TRL-RMF/Caato-Documentation/README.md

# Caato-Documentation

find website at https://trl-rmf.github.io/Caato-Documentation/
