TRL-RMF/Caato-Documentation/src/Chassis.md

# Chassis Assembly

Chassis Assembly of Caato

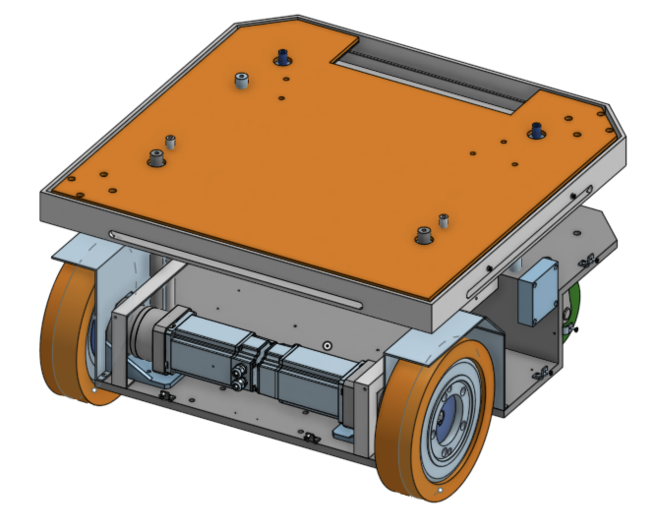
[picture p1: src/img/chassis.png]
Chassis Assembly
