TRL-RMF/Caato-Documentation/src/Drive.md

# Drivetrain Assembly

Drivetrain Assembly of Caato

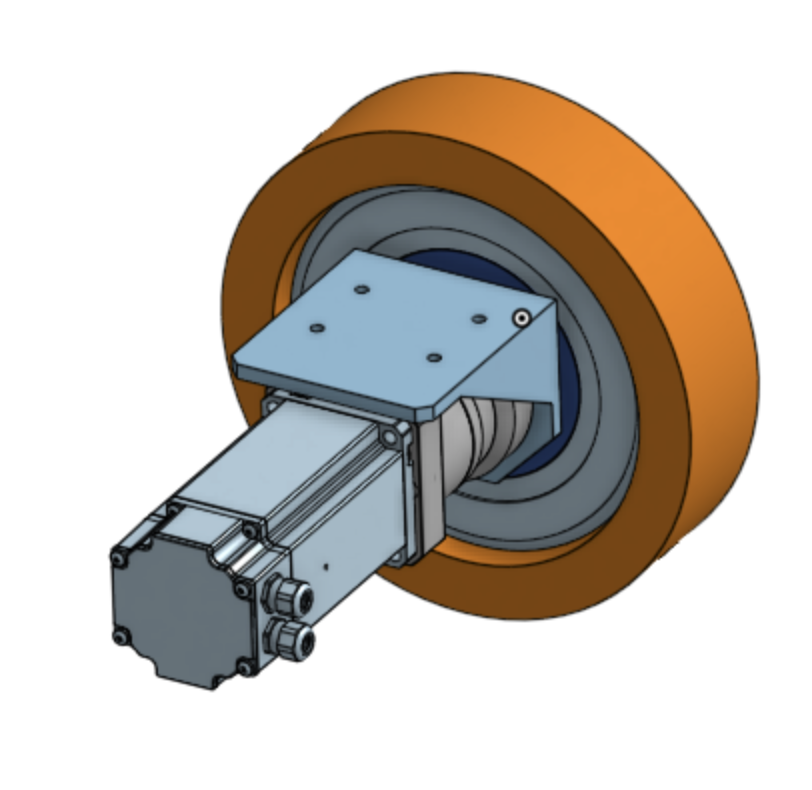
[picture p2: src/img/drive.png]
Drivetrain Assembly
