TRL-RMF/Caato-Documentation/src/Full.md

# Full Assembly

Full assembly of Caato

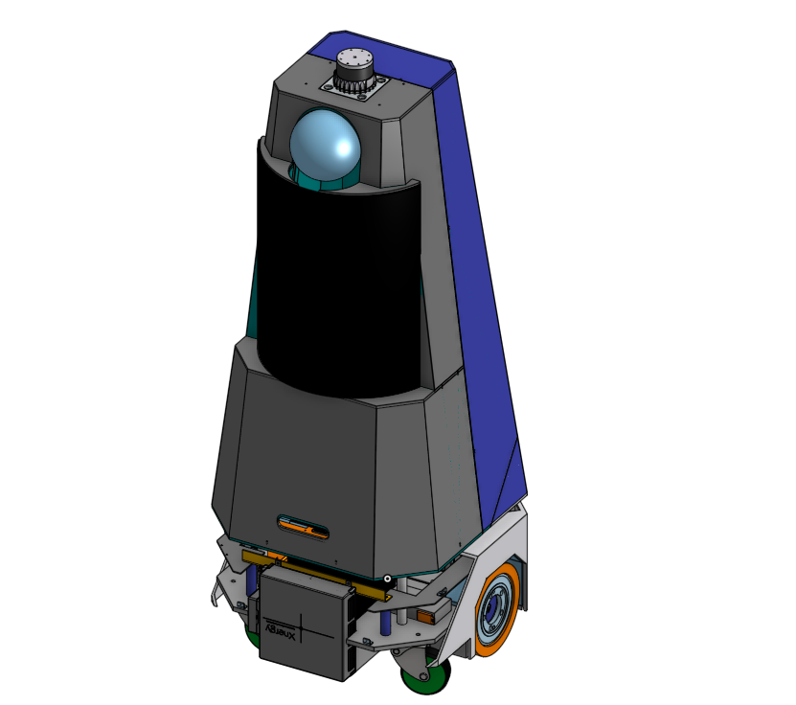
[picture p3: src/img/full.png]
full assembly
