TRL-RMF/Caato-Documentation/src/SUMMARY.md

# Summary

[CAATO*](caato.md)
- [Software*](./Software.md)
- [Mechanical*](./Mechanical.md)
    - [Full Assembly](./Full.md)
    - [Drivetrain Assembly](./Drive.md)
    - [Chassis Assembly](./Chassis.md)
    - [BOM](./BOM_mec.md)
- [Electrical & Electronics](./Electrical.md)
    - [Table of Electronics*](./Table.md)
    - [Power Diagram and Schematics](./Power.md)
    - [Programmable Logic Controller](./Programmable.md)
- [Other Peripherals](./Other.md)
    - [CAATO Arm](./Arm.md)
    - [LED Strip](./Strip.md)
    - [Amazon Alexa](./Alexa.md)
    - [LED Panel](./Panel.md)
    - [Roboteq and Motor Tuning](./Roboteq.md)
- [BOM](./BOM.md)
- [Operation](./Operation.md)
    - [On-Site Operation](./site.md)
    - [3D Mapping](./3D.md)
    - [Testing Plan (Navigation)](./testing.md)
- [Annex](./Annex.md)
