TRL-RMF/Caato-Documentation/src/pdf/Schematic.pdf

## Elec 24V

## RJ45 TO NUC

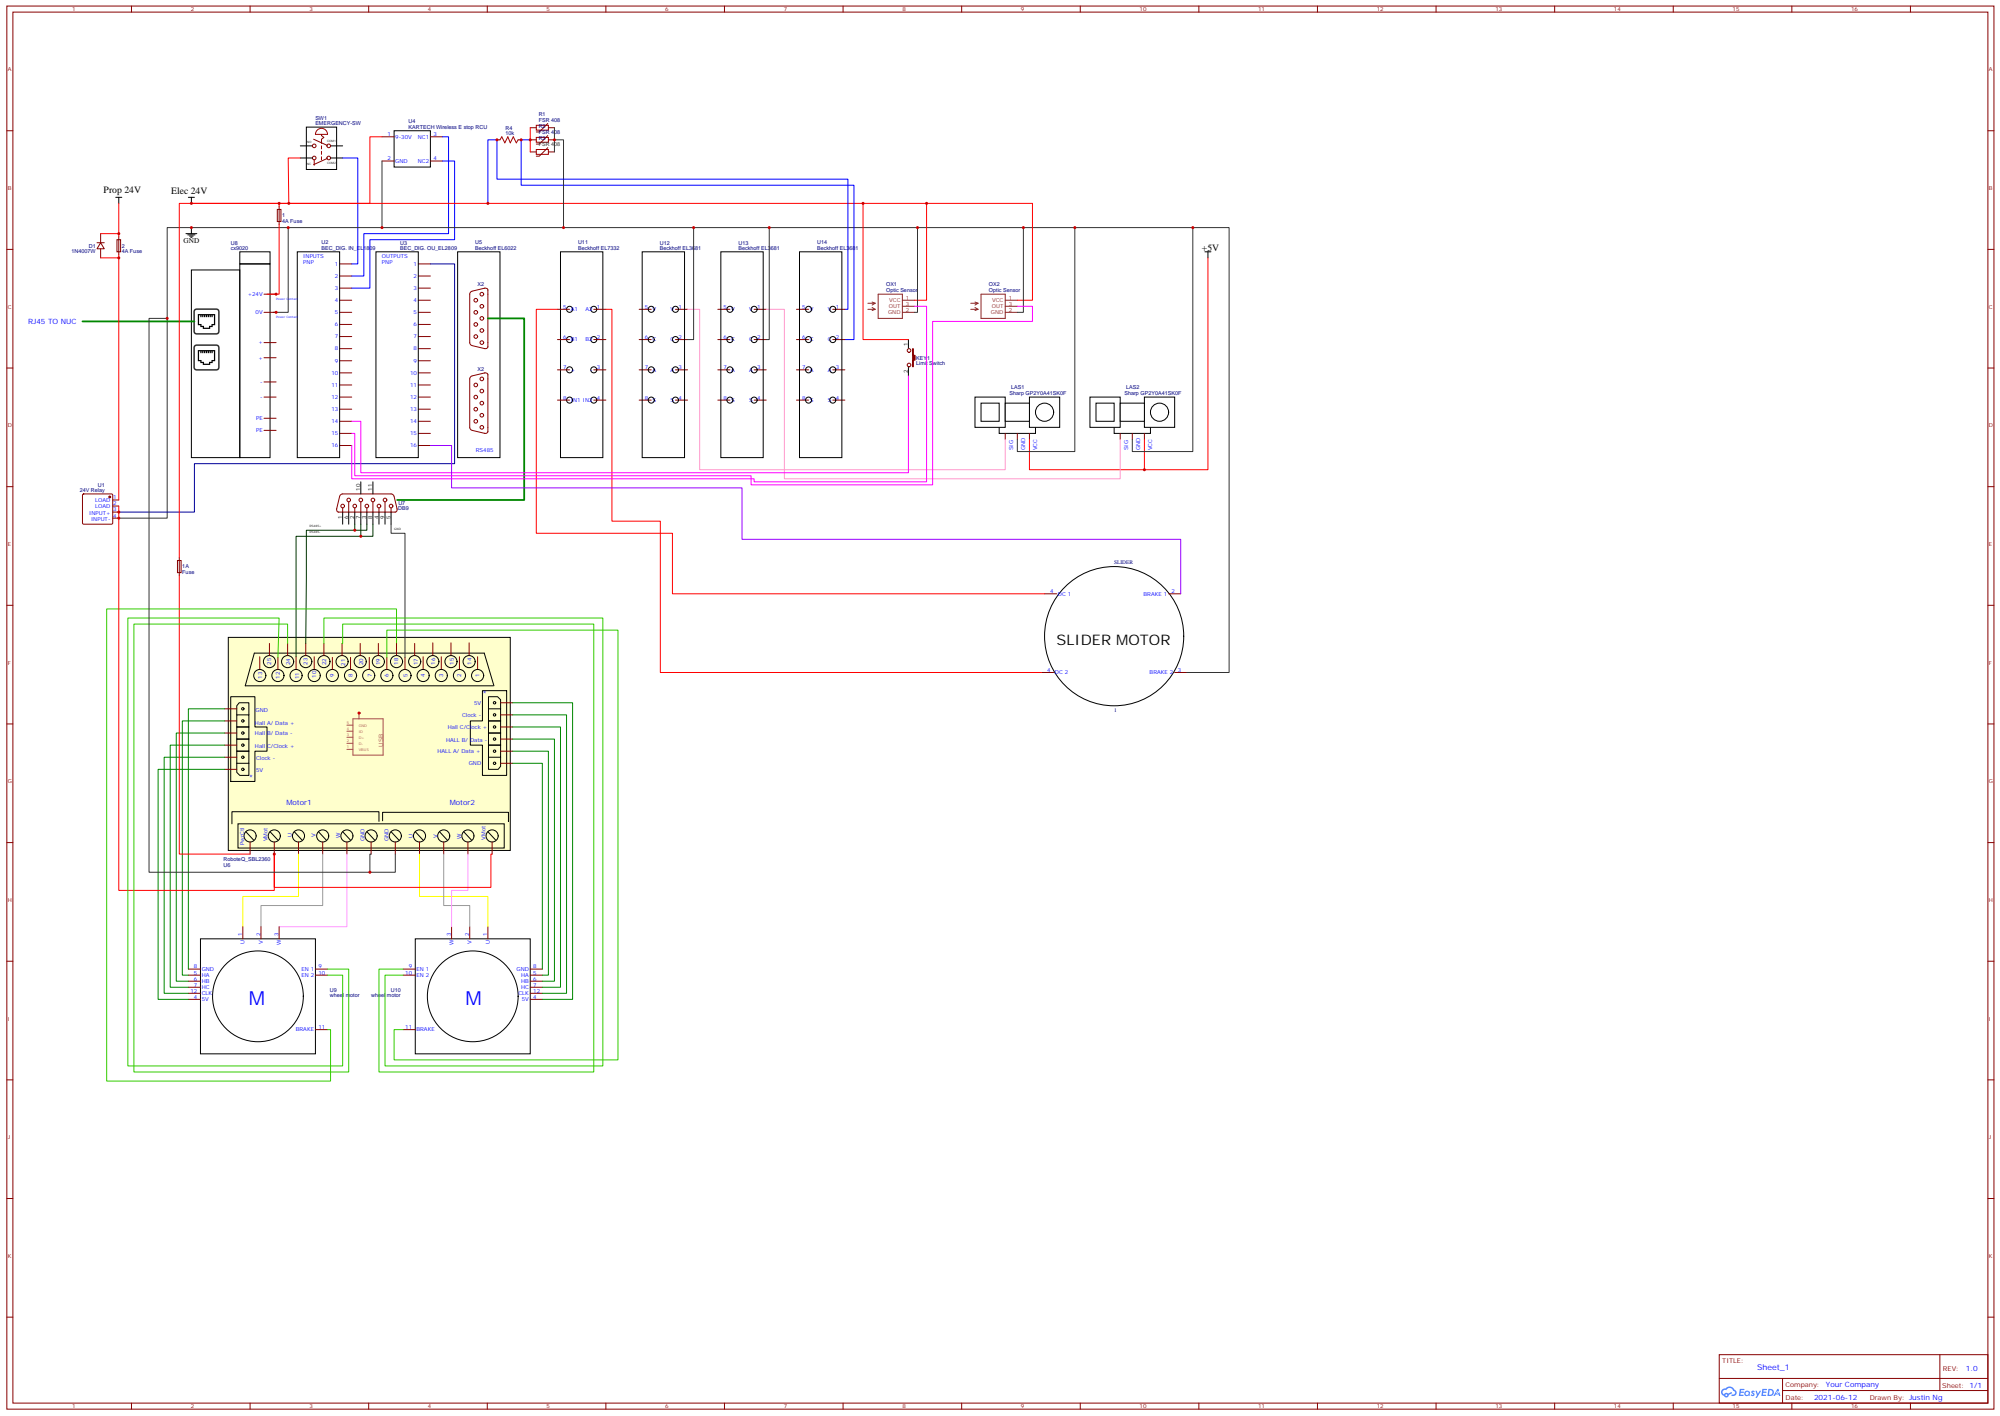
[picture p9: page 1]

Drawn By: Justin Ng
